Phylliida/piano/refs/README.md

# Reference repositories

Cloned here for reading, not committed. To get them back:

| folder | repository | commit read |
|---|---|---|
| `HE60` | https://github.com/peppapighs/HE60.git | `501871e` (2026-07-05) |
| `libhmk` | https://github.com/peppapighs/libhmk.git | `ad426f0` (2026-07-19) |
| `fluxpad` | https://github.com/sssata/fluxpad.git | `8b2e752` (2023-10-16) |
| `minipad-firmware` | https://github.com/minipadKB/minipad-firmware.git | `ba1b653` (2024-06-06) |
| `marbastlib` | https://github.com/ebastler/marbastlib.git | `6b0a9a7` (2026-03-22) |

The tile's sensing chain (one Hall sensor per key, an 8:1 mux per row, the
AT32F405) follows HE60, and its firmware is libhmk.
