Phylliida/piano/cad/coupon_tray.stl

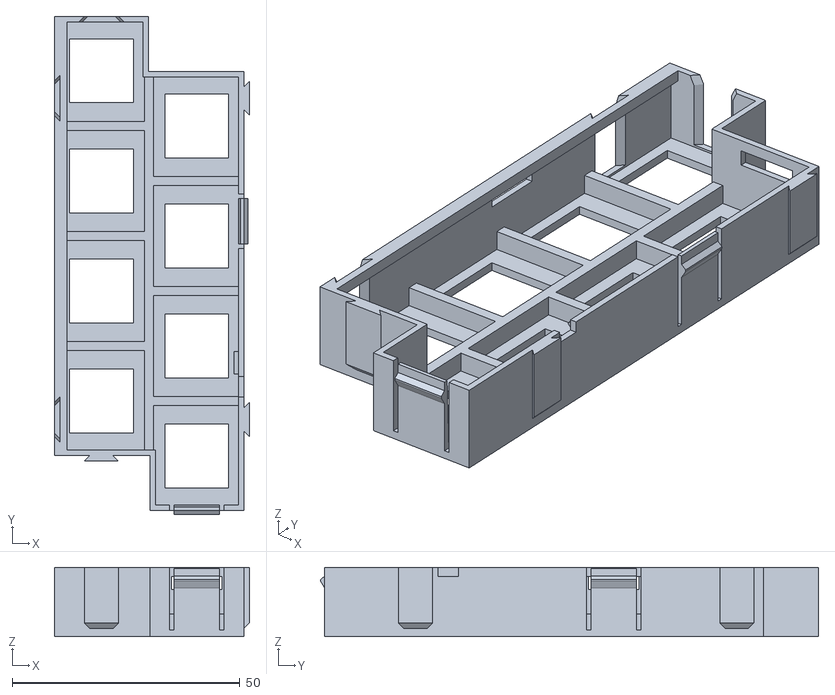
[picture p1: CAD file, 2026-11-13]
cad/coupon_tray.stl
42.8 x 109.3 x 15.2
