Phylliida/piano/cad/coupon_cover.stl

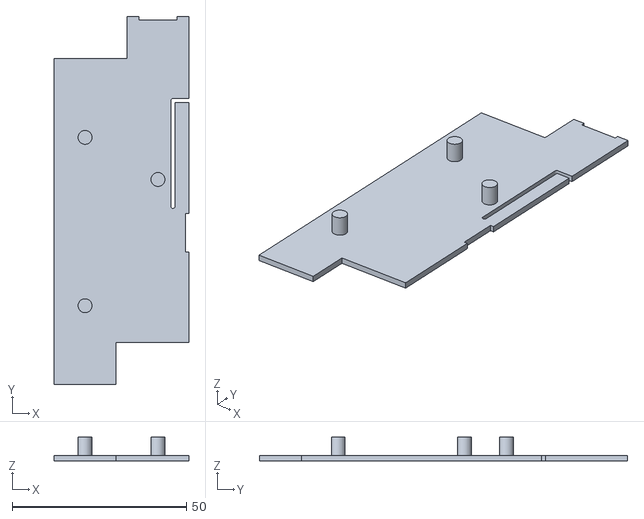
[picture p2: CAD file, 2026-11-13]
cad/coupon_cover.stl
38.7 x 105.6 x 6.80
