Phylliida/piano/cad/tray.stl

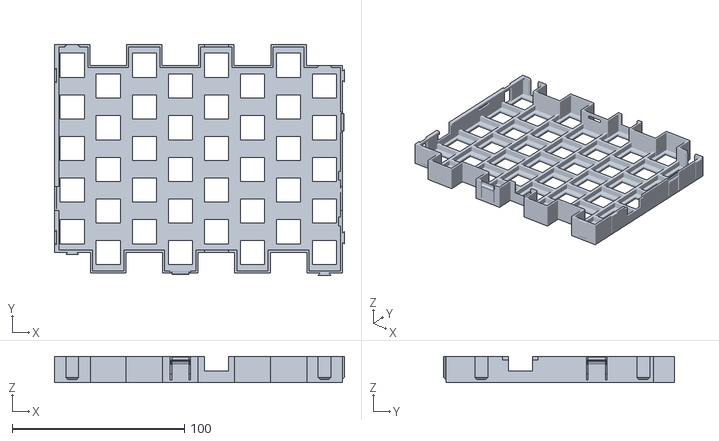
[picture p3: CAD file, 2026-11-13]
cad/tray.stl
168.3 x 133.8 x 15.2
