Phylliida/piano/cad/cover.stl

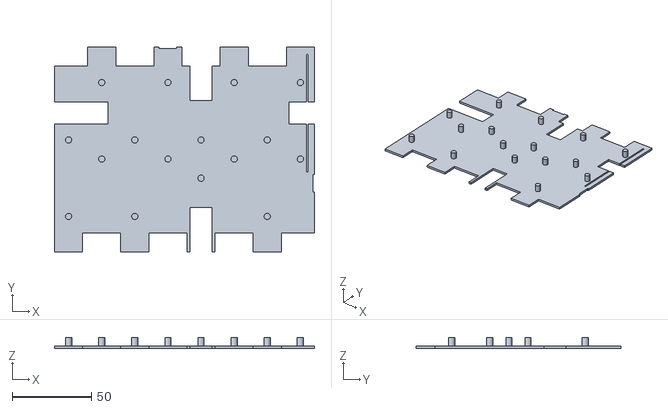
[picture p4: CAD file, 2026-11-13]
cad/cover.stl
164.2 x 129.7 x 6.80
