Phylliida/piano/cad/coupon_pcb_dummy.stl

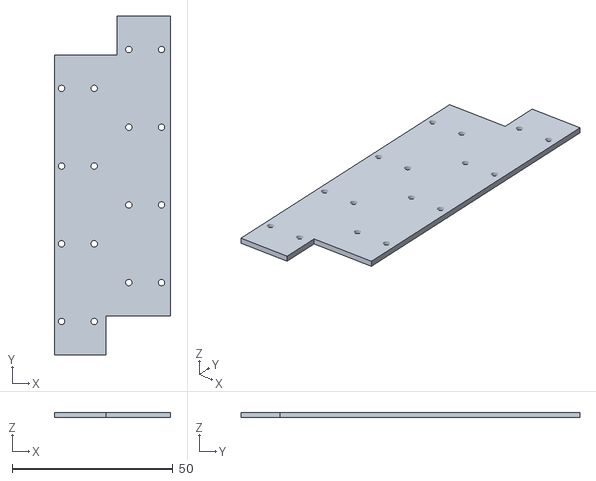
[picture p5: CAD file, 2026-11-13]
cad/coupon_pcb_dummy.stl
36.1 x 105.4 x 1.60
