Phylliida/piano/cad/plate_test.stl

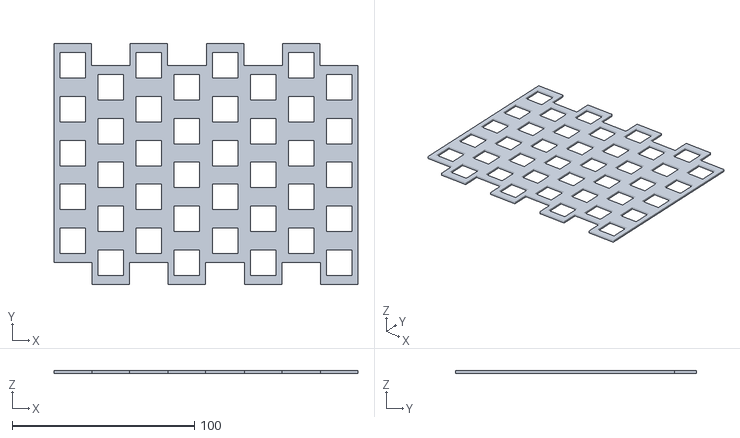
[picture p6: CAD file, 2026-11-10]
cad/plate_test.stl
167.0 x 132.5 x 1.50
