Phylliida/piano/cad/pcb_dummy.stl

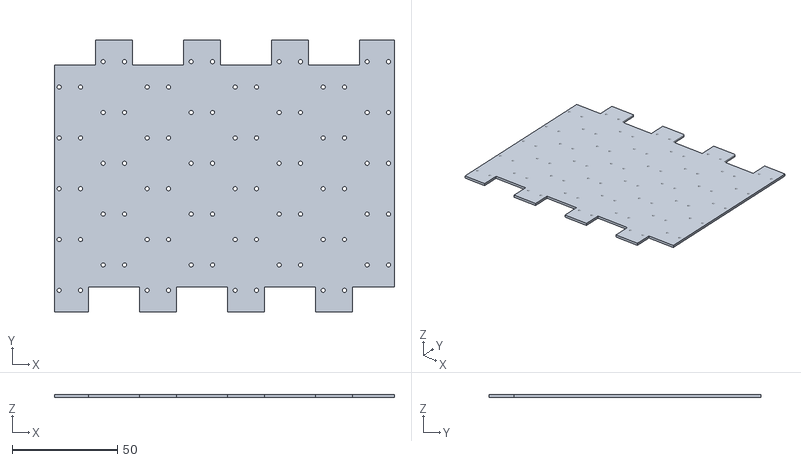
[picture p7: CAD file, 2026-11-10]
cad/pcb_dummy.stl
161.6 x 129.5 x 1.60
