Phylliida/piano/pcb/tile.kicad_pcb

## KiCad design pcb/tile.kicad_pcb (2026-11-13)

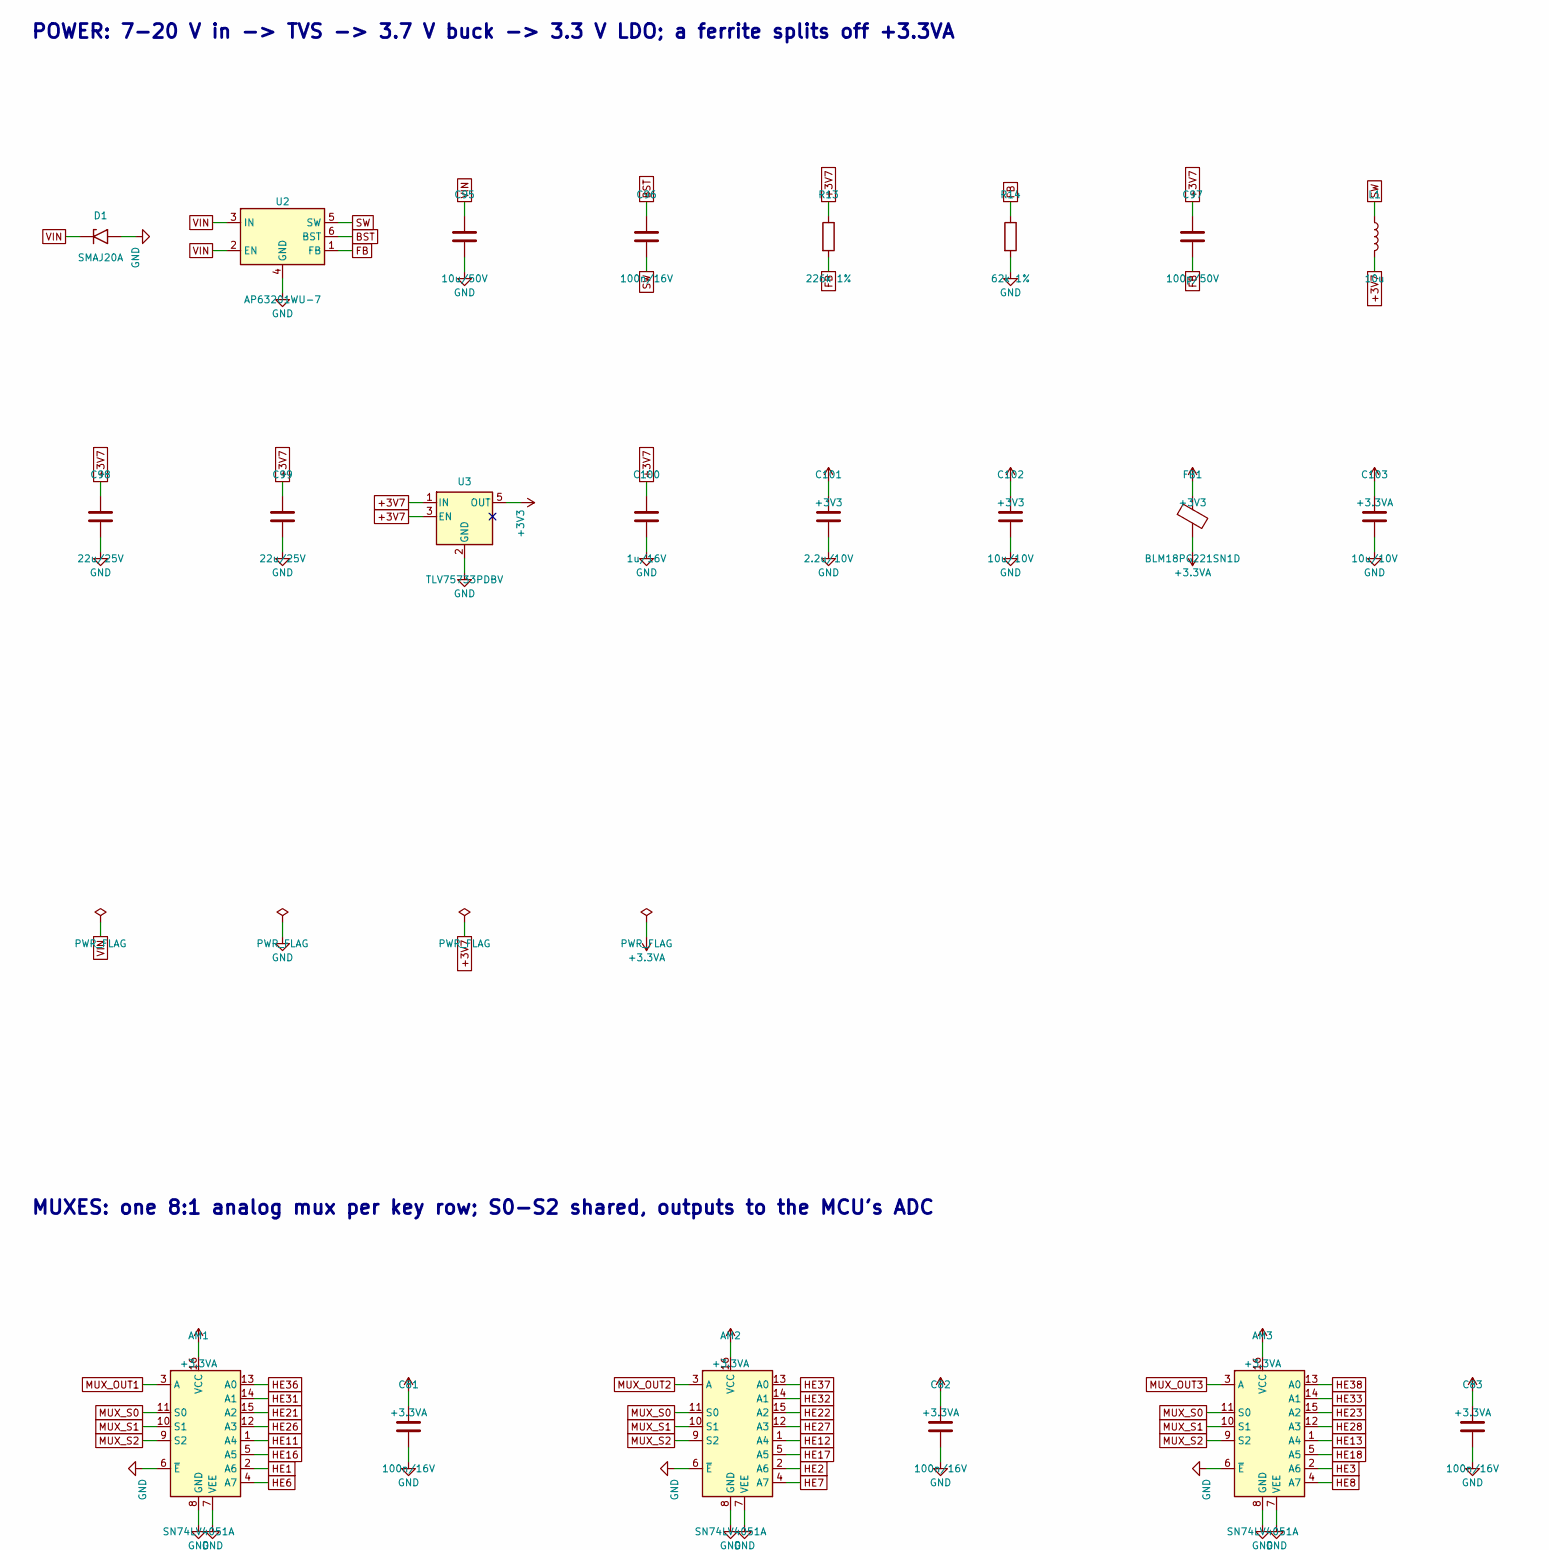
[picture p8: schematic tile.kicad_sch, Hex keyboard tile 8x5, part in row 1, column 1]

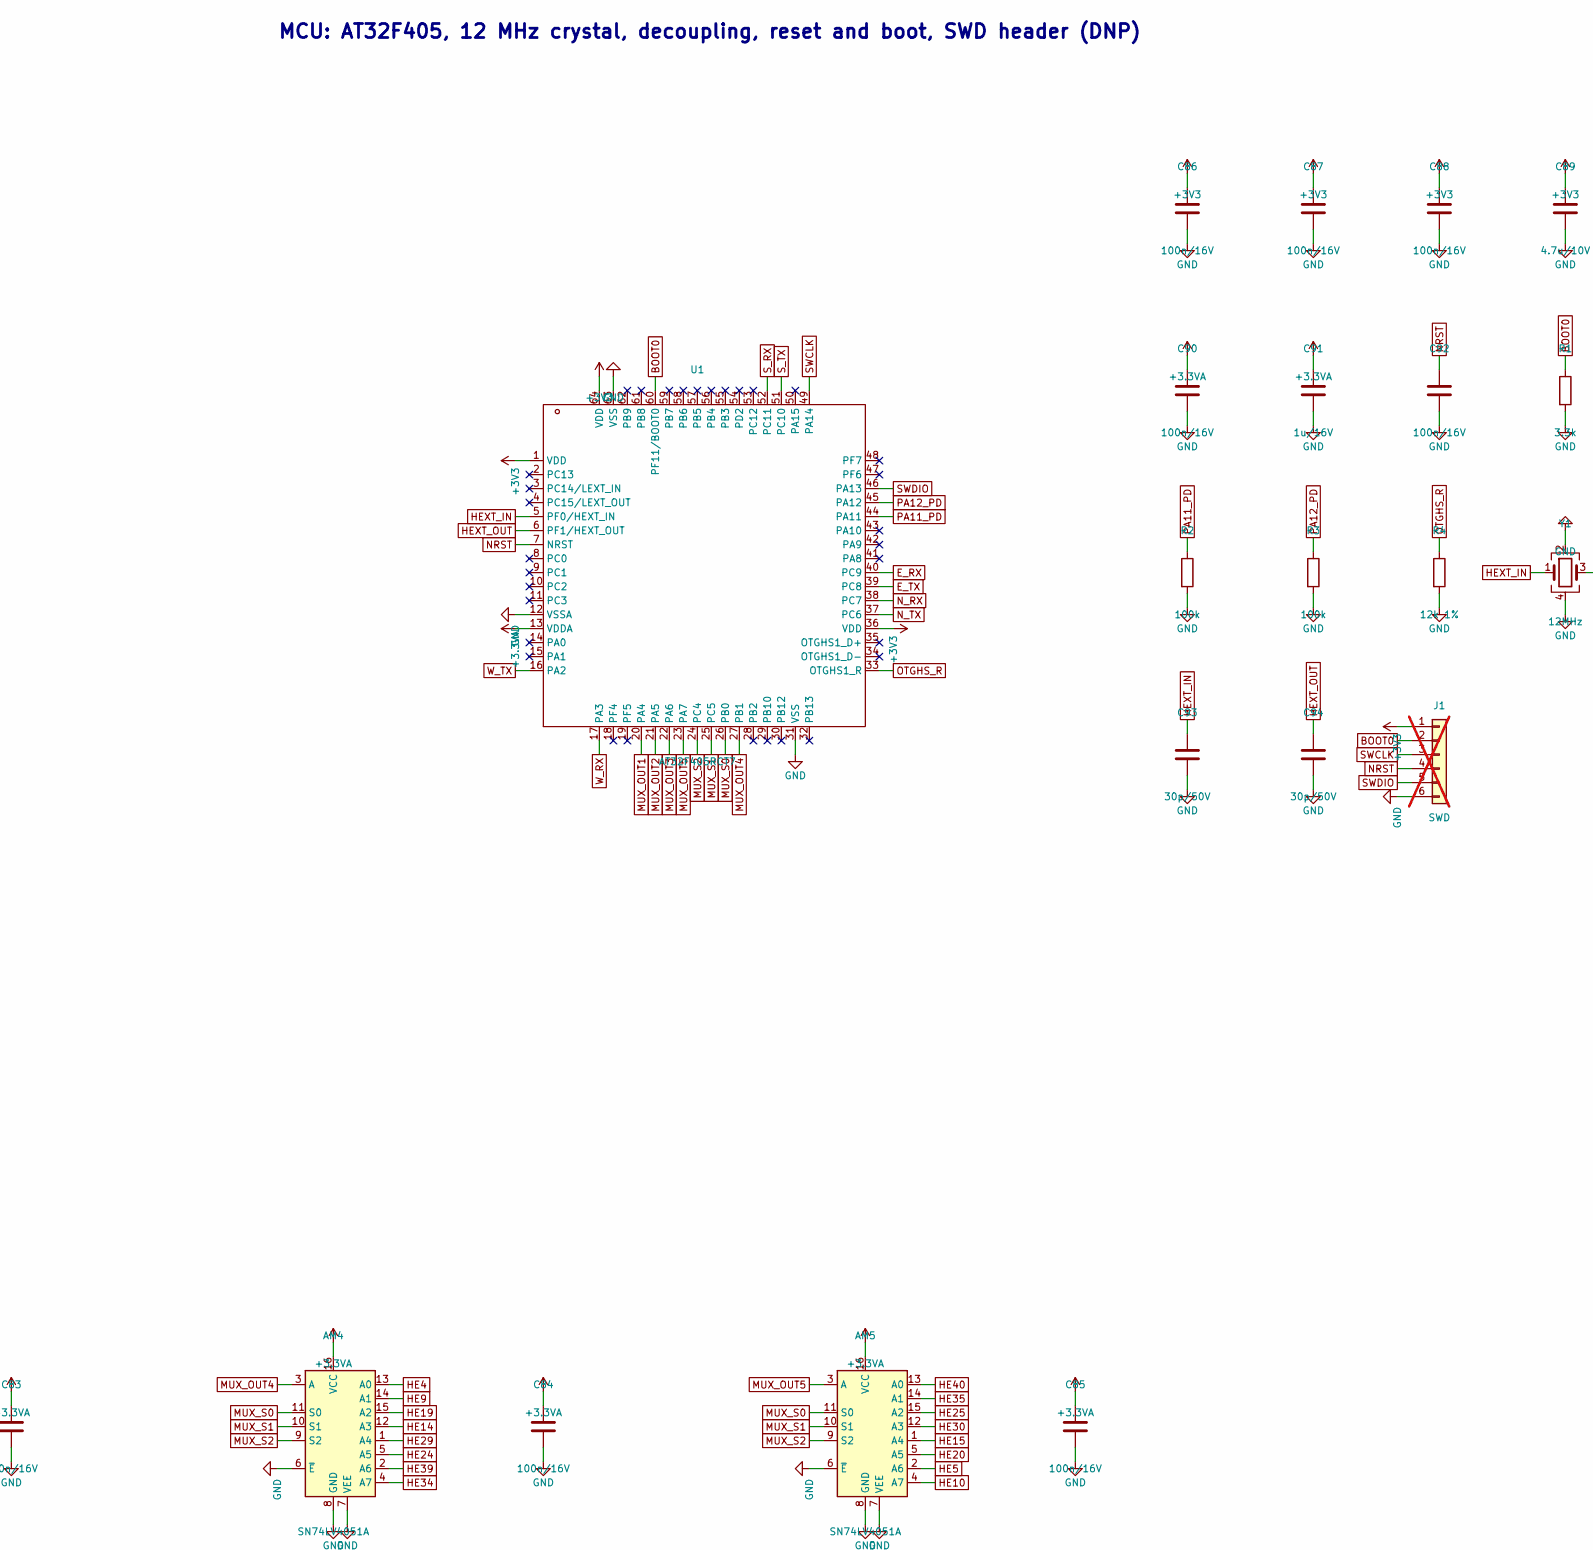
[picture p9: schematic tile.kicad_sch, Hex keyboard tile 8x5, part in row 1, column 2]

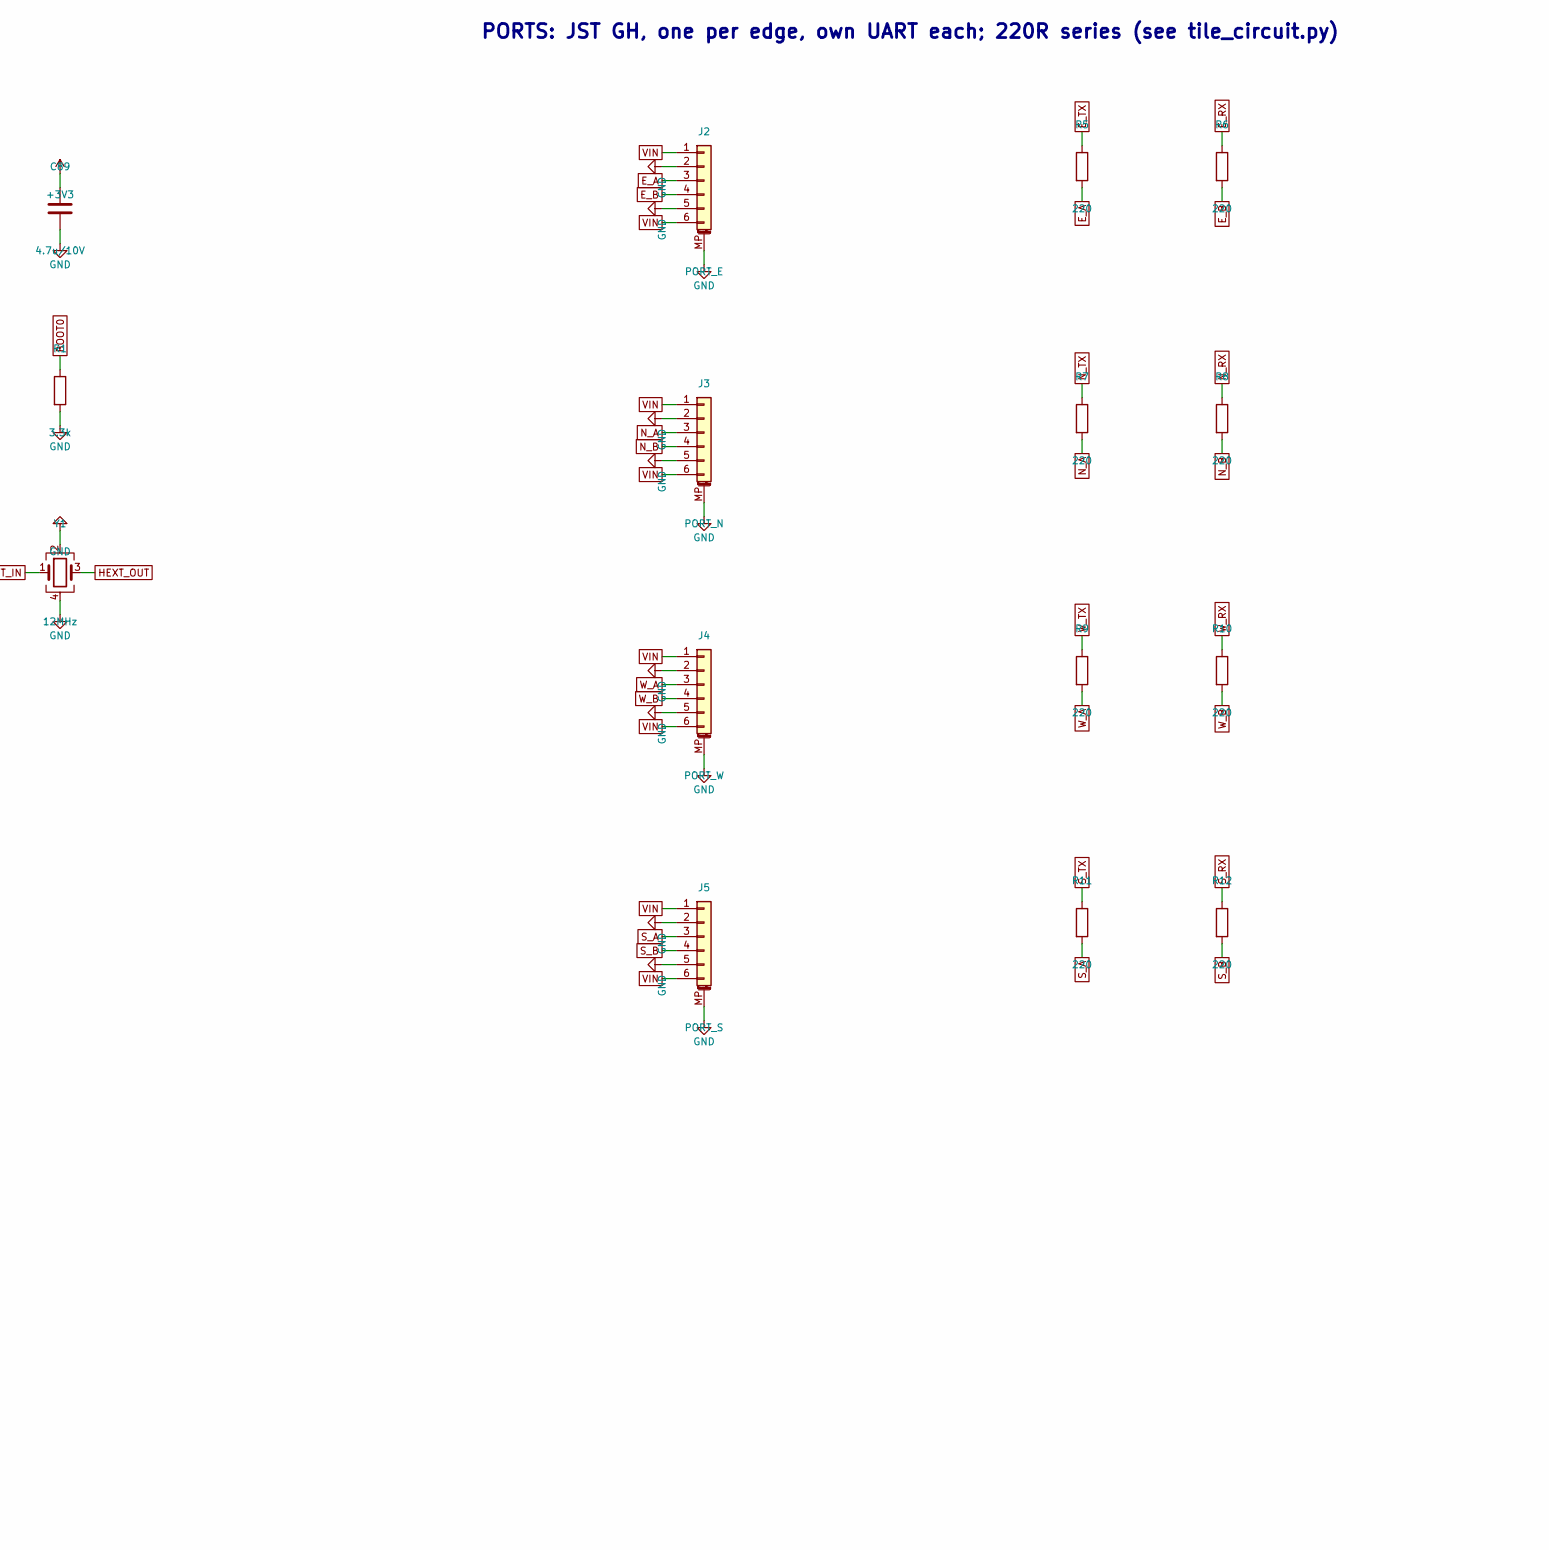
[picture p10: schematic tile.kicad_sch, Hex keyboard tile 8x5, part in row 1, column 3]

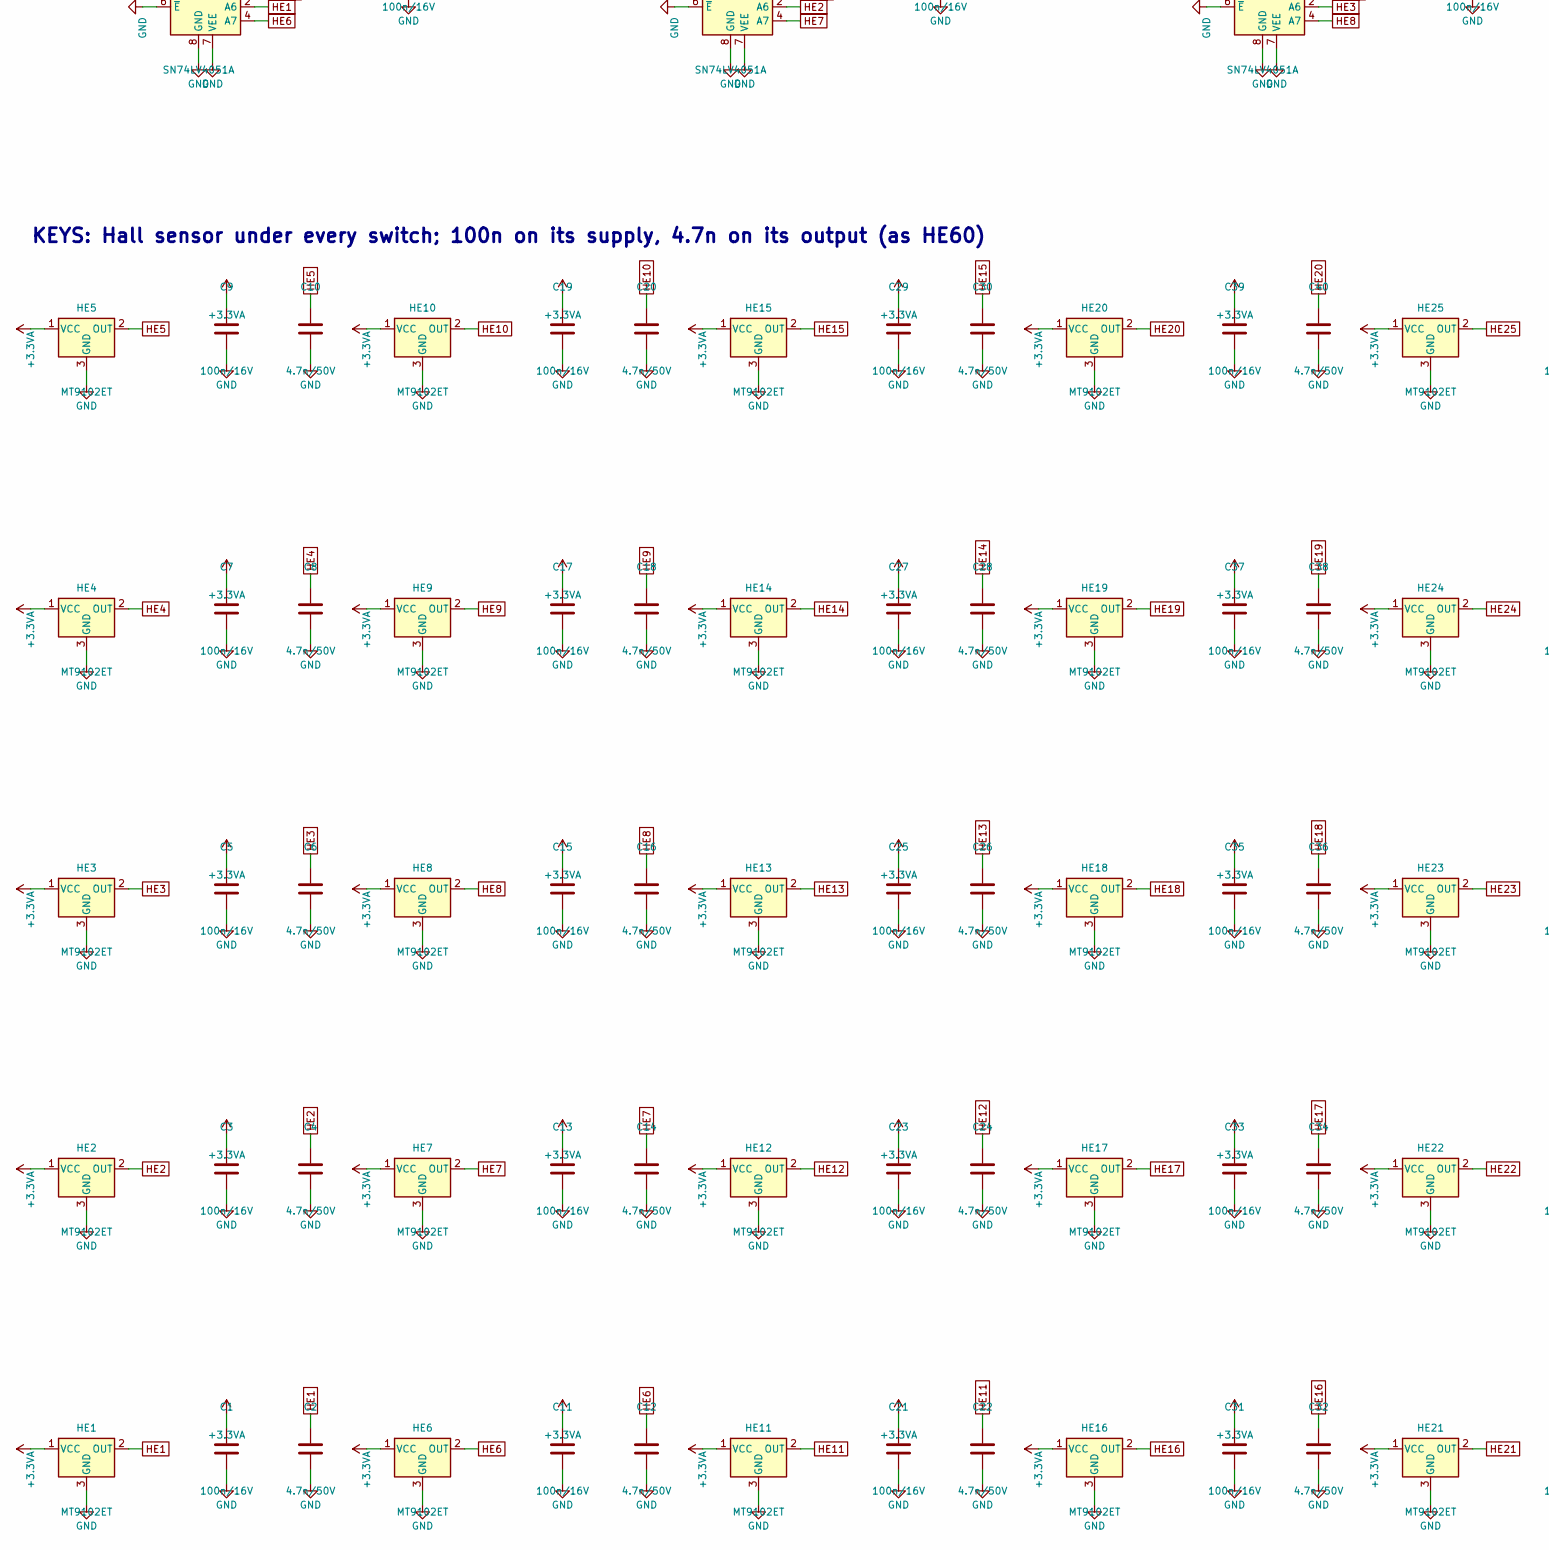
[picture p11: schematic tile.kicad_sch, Hex keyboard tile 8x5, part in row 2, column 1]

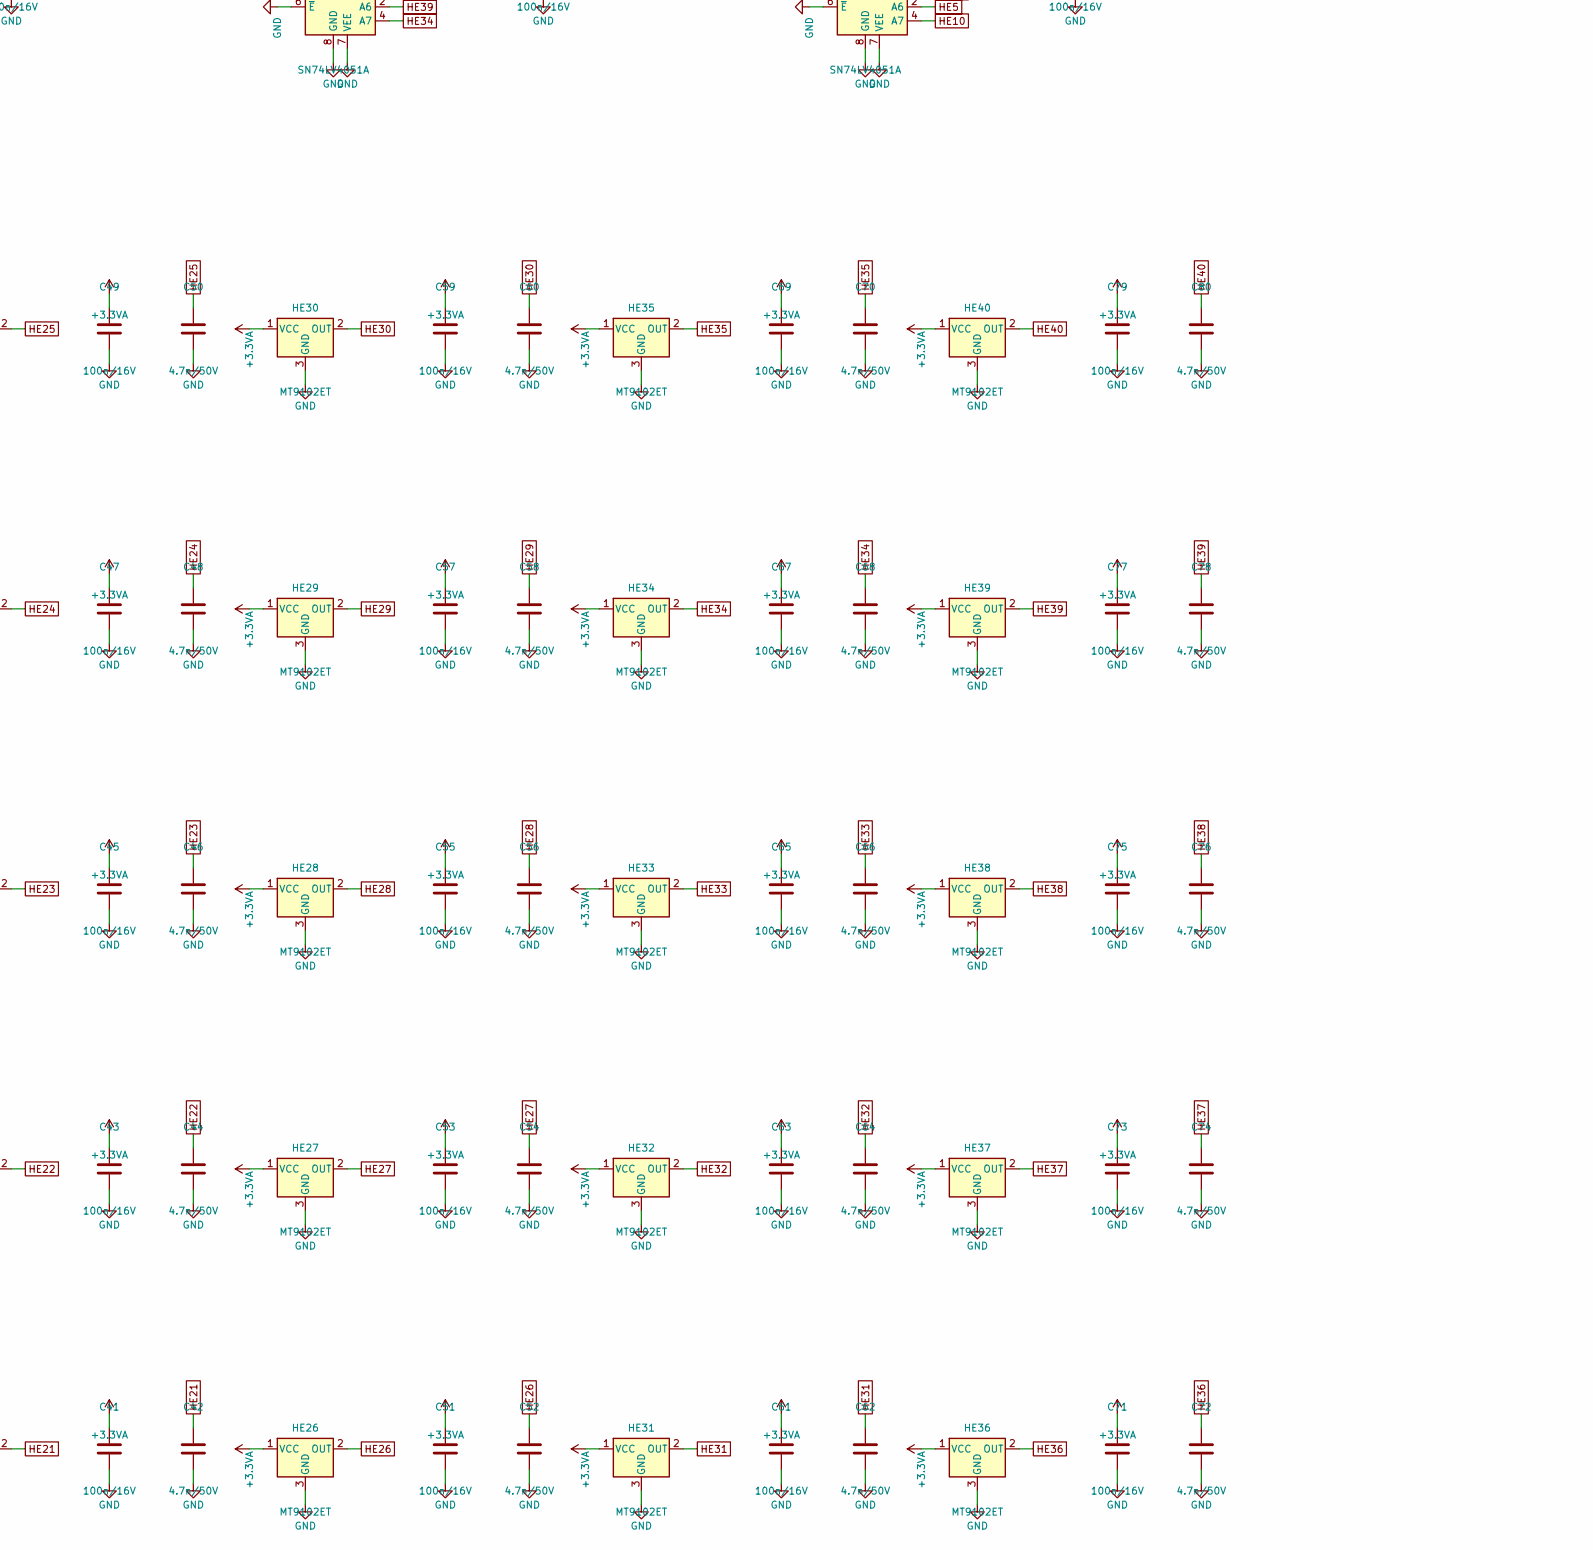
[picture p12: schematic tile.kicad_sch, Hex keyboard tile 8x5, part in row 2, column 2]

Parts:
AM1, AM2, AM3, AM4, AM5: SN74LV4051A; TSSOP-16_4.4x5mm_P0.65mm; MPN SN74LV4051APWR
C1, C3, C5, C7, C9, C11, C13, C15, C17, C19, C21, C23, C25, C27, C29, C31, C33, C35, C37, C39, C41, C43, C45, C47, C49, C51, C53, C55, C57, C59, C61, C63, C65, C67, C69, C71, C73, C75, C77, C79, C81, C82, C83, C84, C85, C86, C87, C88, C90, C92, C96: 100n/16V; C_0402_1005Metric
C2, C4, C6, C8, C10, C12, C14, C16, C18, C20, C22, C24, C26, C28, C30, C32, C34, C36, C38, C40, C42, C44, C46, C48, C50, C52, C54, C56, C58, C60, C62, C64, C66, C68, C70, C72, C74, C76, C78, C80: 4.7n/50V; C_0402_1005Metric
C89: 4.7u/10V; C_0603_1608Metric
C91, C100: 1u/16V; C_0402_1005Metric
C93, C94: 30p/50V; C_0402_1005Metric
C95: 10u/50V; C_1206_3216Metric
C97: 100p/50V; C_0402_1005Metric
C98, C99: 22u/25V; C_0805_2012Metric
C101: 2.2u/10V; C_0603_1608Metric
C102, C103: 10u/10V; C_0805_2012Metric
D1: SMAJ20A; D_SMA
FB1: BLM18PG221SN1D; L_0603_1608Metric; MPN BLM18PG221SN1D
HE1, HE2, HE3, HE4, HE5, HE6, HE7, HE8, HE9, HE10, HE11, HE12, HE13, HE14, HE15, HE16, HE17, HE18, HE19, HE20, HE21, HE22, HE23, HE24, HE25, HE26, HE27, HE28, HE29, HE30, HE31, HE32, HE33, HE34, HE35, HE36, HE37, HE38, HE39, HE40: MT9102ET; SOT-23-3
J1: SWD; PinHeader_1x06_P2.54mm_Vertical_SMD_Pin1Left; not fitted
J2: PORT_E; JST_GH_SM06B-GHS-TB_1x06-1MP_P1.25mm_Horizontal; MPN SM06B-GHS-TB
J3: PORT_N; JST_GH_SM06B-GHS-TB_1x06-1MP_P1.25mm_Horizontal; MPN SM06B-GHS-TB
J4: PORT_W; JST_GH_SM06B-GHS-TB_1x06-1MP_P1.25mm_Horizontal; MPN SM06B-GHS-TB
J5: PORT_S; JST_GH_SM06B-GHS-TB_1x06-1MP_P1.25mm_Horizontal; MPN SM06B-GHS-TB
L1: 10u; L_Changjiang_FNR4030S; MPN FNR4030S100MT
R1: 3.3k; R_0402_1005Metric
R2, R3: 100k; R_0402_1005Metric
R4: 12k 1%; R_0402_1005Metric
R5, R6, R7, R8, R9, R10, R11, R12: 220; R_0402_1005Metric
R13: 226k 1%; R_0402_1005Metric
R14: 62k 1%; R_0402_1005Metric
U1: AT32F405RCT7; LQFP-64_10x10mm_P0.5mm; MPN AT32F405RCT7
U2: AP63201WU-7; TSOT-23-6
U3: TLV75733PDBV; SOT-23-5
Y1: 12MHz; Crystal_SMD_3225-4Pin_3.2x2.5mm; MPN X322512MSB4SI

Connections:
+3.3VA: AM1.16 (VCC), AM2.16 (VCC), AM3.16 (VCC), AM4.16 (VCC), AM5.16 (VCC), C1.1, C3.1, C5.1, C7.1, C9.1, C11.1, C13.1, C15.1, C17.1, C19.1, C21.1, C23.1, C25.1, C27.1, C29.1, C31.1, C33.1, C35.1, C37.1, C39.1, C41.1, C43.1, C45.1, C47.1, C49.1, C51.1, C53.1, C55.1, C57.1, C59.1, C61.1, C63.1, C65.1, C67.1, C69.1, C71.1, C73.1, C75.1, C77.1, C79.1, C81.1, C82.1, C83.1, C84.1, C85.1, C90.1, C91.1, C103.1, FB1.2, HE1.1 (VCC), HE2.1 (VCC), HE3.1 (VCC), HE4.1 (VCC), HE5.1 (VCC), HE6.1 (VCC), HE7.1 (VCC), HE8.1 (VCC), HE9.1 (VCC), HE10.1 (VCC), HE11.1 (VCC), HE12.1 (VCC), HE13.1 (VCC), HE14.1 (VCC), HE15.1 (VCC), HE16.1 (VCC), HE17.1 (VCC), HE18.1 (VCC), HE19.1 (VCC), HE20.1 (VCC), HE21.1 (VCC), HE22.1 (VCC), HE23.1 (VCC), HE24.1 (VCC), HE25.1 (VCC), HE26.1 (VCC), HE27.1 (VCC), HE28.1 (VCC), HE29.1 (VCC), HE30.1 (VCC), HE31.1 (VCC), HE32.1 (VCC), HE33.1 (VCC), HE34.1 (VCC), HE35.1 (VCC), HE36.1 (VCC), HE37.1 (VCC), HE38.1 (VCC), HE39.1 (VCC), HE40.1 (VCC), U1.13 (VDDA)
+3V3: C86.1, C87.1, C88.1, C89.1, C101.1, C102.1, FB1.1, J1.1, U1.1 (VDD), U1.36 (VDD), U1.64 (VDD), U3.5 (OUT)
+3V7: C97.1, C98.1, C99.1, C100.1, L1.2, R13.1, U3.1 (IN), U3.3 (EN)
BOOT0: J1.2, R1.1, U1.60 (PF11/BOOT0)
BST: C96.1, U2.6 (BST)
E_A: J2.3, R5.2
E_B: J2.4, R6.2
E_RX: R6.1, U1.40 (PC9)
E_TX: R5.1, U1.39 (PC8)
FB: C97.2, R13.2, R14.1, U2.1 (FB)
GND: AM1.6 (~E), AM1.7 (VEE), AM1.8 (GND), AM2.6 (~E), AM2.7 (VEE), AM2.8 (GND), AM3.6 (~E), AM3.7 (VEE), AM3.8 (GND), AM4.6 (~E), AM4.7 (VEE), AM4.8 (GND), AM5.6 (~E), AM5.7 (VEE), AM5.8 (GND), C1.2, C2.2, C3.2, C4.2, C5.2, C6.2, C7.2, C8.2, C9.2, C10.2, C11.2, C12.2, C13.2, C14.2, C15.2, C16.2, C17.2, C18.2, C19.2, C20.2, C21.2, C22.2, C23.2, C24.2, C25.2, C26.2, C27.2, C28.2, C29.2, C30.2, C31.2, C32.2, C33.2, C34.2, C35.2, C36.2, C37.2, C38.2, C39.2, C40.2, C41.2, C42.2, C43.2, C44.2, C45.2, C46.2, C47.2, C48.2, C49.2, C50.2, C51.2, C52.2, C53.2, C54.2, C55.2, C56.2, C57.2, C58.2, C59.2, C60.2, C61.2, C62.2, C63.2, C64.2, C65.2, C66.2, C67.2, C68.2, C69.2, C70.2, C71.2, C72.2, C73.2, C74.2, C75.2, C76.2, C77.2, C78.2, C79.2, C80.2, C81.2, C82.2, C83.2, C84.2, C85.2, C86.2, C87.2, C88.2, C89.2, C90.2, C91.2, C92.2, C93.2, C94.2, C95.2, C98.2, C99.2, C100.2, C101.2, C102.2, C103.2, D1.2 (A2), HE1.3 (GND), HE2.3 (GND), HE3.3 (GND), HE4.3 (GND), HE5.3 (GND), HE6.3 (GND), HE7.3 (GND), HE8.3 (GND), HE9.3 (GND), HE10.3 (GND), HE11.3 (GND), HE12.3 (GND), HE13.3 (GND), HE14.3 (GND), HE15.3 (GND), HE16.3 (GND), HE17.3 (GND), HE18.3 (GND), HE19.3 (GND), HE20.3 (GND), HE21.3 (GND), HE22.3 (GND), HE23.3 (GND), HE24.3 (GND), HE25.3 (GND), HE26.3 (GND), HE27.3 (GND), HE28.3 (GND), HE29.3 (GND), HE30.3 (GND), HE31.3 (GND), HE32.3 (GND), HE33.3 (GND), HE34.3 (GND), HE35.3 (GND), HE36.3 (GND), HE37.3 (GND), HE38.3 (GND), HE39.3 (GND), HE40.3 (GND), J1.6, J2.2, J2.5, J2.MP (MountPin), J3.2, J3.5, J3.MP (MountPin), J4.2, J4.5, J4.MP (MountPin), J5.2, J5.5, J5.MP (MountPin), R1.2, R2.2, R3.2, R4.2, R14.2, U1.12 (VSSA), U1.31 (VSS), U1.63 (VSS), U2.4 (GND), U3.2 (GND), Y1.2, Y1.4
HE1: AM1.2 (A6), C2.1, HE1.2 (OUT)
HE2: AM2.2 (A6), C4.1, HE2.2 (OUT)
HE3: AM3.2 (A6), C6.1, HE3.2 (OUT)
HE4: AM4.13 (A0), C8.1, HE4.2 (OUT)
HE5: AM5.2 (A6), C10.1, HE5.2 (OUT)
HE6: AM1.4 (A7), C12.1, HE6.2 (OUT)
HE7: AM2.4 (A7), C14.1, HE7.2 (OUT)
HE8: AM3.4 (A7), C16.1, HE8.2 (OUT)
HE9: AM4.14 (A1), C18.1, HE9.2 (OUT)
HE10: AM5.4 (A7), C20.1, HE10.2 (OUT)
HE11: AM1.1 (A4), C22.1, HE11.2 (OUT)
HE12: AM2.1 (A4), C24.1, HE12.2 (OUT)
HE13: AM3.1 (A4), C26.1, HE13.2 (OUT)
HE14: AM4.12 (A3), C28.1, HE14.2 (OUT)
HE15: AM5.1 (A4), C30.1, HE15.2 (OUT)
HE16: AM1.5 (A5), C32.1, HE16.2 (OUT)
HE17: AM2.5 (A5), C34.1, HE17.2 (OUT)
HE18: AM3.5 (A5), C36.1, HE18.2 (OUT)
HE19: AM4.15 (A2), C38.1, HE19.2 (OUT)
HE20: AM5.5 (A5), C40.1, HE20.2 (OUT)
HE21: AM1.15 (A2), C42.1, HE21.2 (OUT)
HE22: AM2.15 (A2), C44.1, HE22.2 (OUT)
HE23: AM3.15 (A2), C46.1, HE23.2 (OUT)
HE24: AM4.5 (A5), C48.1, HE24.2 (OUT)
HE25: AM5.15 (A2), C50.1, HE25.2 (OUT)
HE26: AM1.12 (A3), C52.1, HE26.2 (OUT)
HE27: AM2.12 (A3), C54.1, HE27.2 (OUT)
HE28: AM3.12 (A3), C56.1, HE28.2 (OUT)
HE29: AM4.1 (A4), C58.1, HE29.2 (OUT)
HE30: AM5.12 (A3), C60.1, HE30.2 (OUT)
HE31: AM1.14 (A1), C62.1, HE31.2 (OUT)
HE32: AM2.14 (A1), C64.1, HE32.2 (OUT)
HE33: AM3.14 (A1), C66.1, HE33.2 (OUT)
HE34: AM4.4 (A7), C68.1, HE34.2 (OUT)
HE35: AM5.14 (A1), C70.1, HE35.2 (OUT)
HE36: AM1.13 (A0), C72.1, HE36.2 (OUT)
HE37: AM2.13 (A0), C74.1, HE37.2 (OUT)
HE38: AM3.13 (A0), C76.1, HE38.2 (OUT)
HE39: AM4.2 (A6), C78.1, HE39.2 (OUT)
HE40: AM5.13 (A0), C80.1, HE40.2 (OUT)
HEXT_IN: C93.1, U1.5 (PF0/HEXT_IN), Y1.1
HEXT_OUT: C94.1, U1.6 (PF1/HEXT_OUT), Y1.3
MUX_OUT1: AM1.3 (A), U1.20 (PA4)
MUX_OUT2: AM2.3 (A), U1.21 (PA5)
MUX_OUT3: AM3.3 (A), U1.22 (PA6)
MUX_OUT4: AM4.3 (A), U1.27 (PB1)
MUX_OUT5: AM5.3 (A), U1.23 (PA7)
MUX_S0: AM1.11 (S0), AM2.11 (S0), AM3.11 (S0), AM4.11 (S0), AM5.11 (S0), U1.26 (PB0)
MUX_S1: AM1.10 (S1), AM2.10 (S1), AM3.10 (S1), AM4.10 (S1), AM5.10 (S1), U1.25 (PC5)
MUX_S2: AM1.9 (S2), AM2.9 (S2), AM3.9 (S2), AM4.9 (S2), AM5.9 (S2), U1.24 (PC4)
NRST: C92.1, J1.4, U1.7 (NRST)
N_A: J3.3, R7.2
N_B: J3.4, R8.2
N_RX: R8.1, U1.38 (PC7)
N_TX: R7.1, U1.37 (PC6)
OTGHS_R: R4.1, U1.33 (OTGHS1_R)
PA11_PD: R2.1, U1.44 (PA11)
PA12_PD: R3.1, U1.45 (PA12)
SW: C96.2, L1.1, U2.5 (SW)
SWCLK: J1.3, U1.49 (PA14)
SWDIO: J1.5, U1.46 (PA13)
S_A: J5.3, R11.2
S_B: J5.4, R12.2
S_RX: R12.1, U1.52 (PC11)
S_TX: R11.1, U1.51 (PC10)
VIN: C95.1, D1.1 (A1), J2.1, J2.6, J3.1, J3.6, J4.1, J4.6, J5.1, J5.6, U2.2 (EN), U2.3 (IN)
W_A: J4.3, R9.2
W_B: J4.4, R10.2
W_RX: R10.1, U1.17 (PA3)
W_TX: R9.1, U1.16 (PA2)

Notes on the sheet:
KEYS: Hall sensor under every switch; 100n on its supply, 4.7n on its output (as HE60)
MUXES: one 8:1 analog mux per key row; S0-S2 shared, outputs to the MCU's ADC
MCU: AT32F405, 12 MHz crystal, decoupling, reset and boot, SWD header (DNP)
PORTS: JST GH, one per edge, own UART each; 220R series (see tile_circuit.py)
POWER: 7-20 V in -> TVS -> 3.7 V buck -> 3.3 V LDO; a ferrite splits off +3.3VA

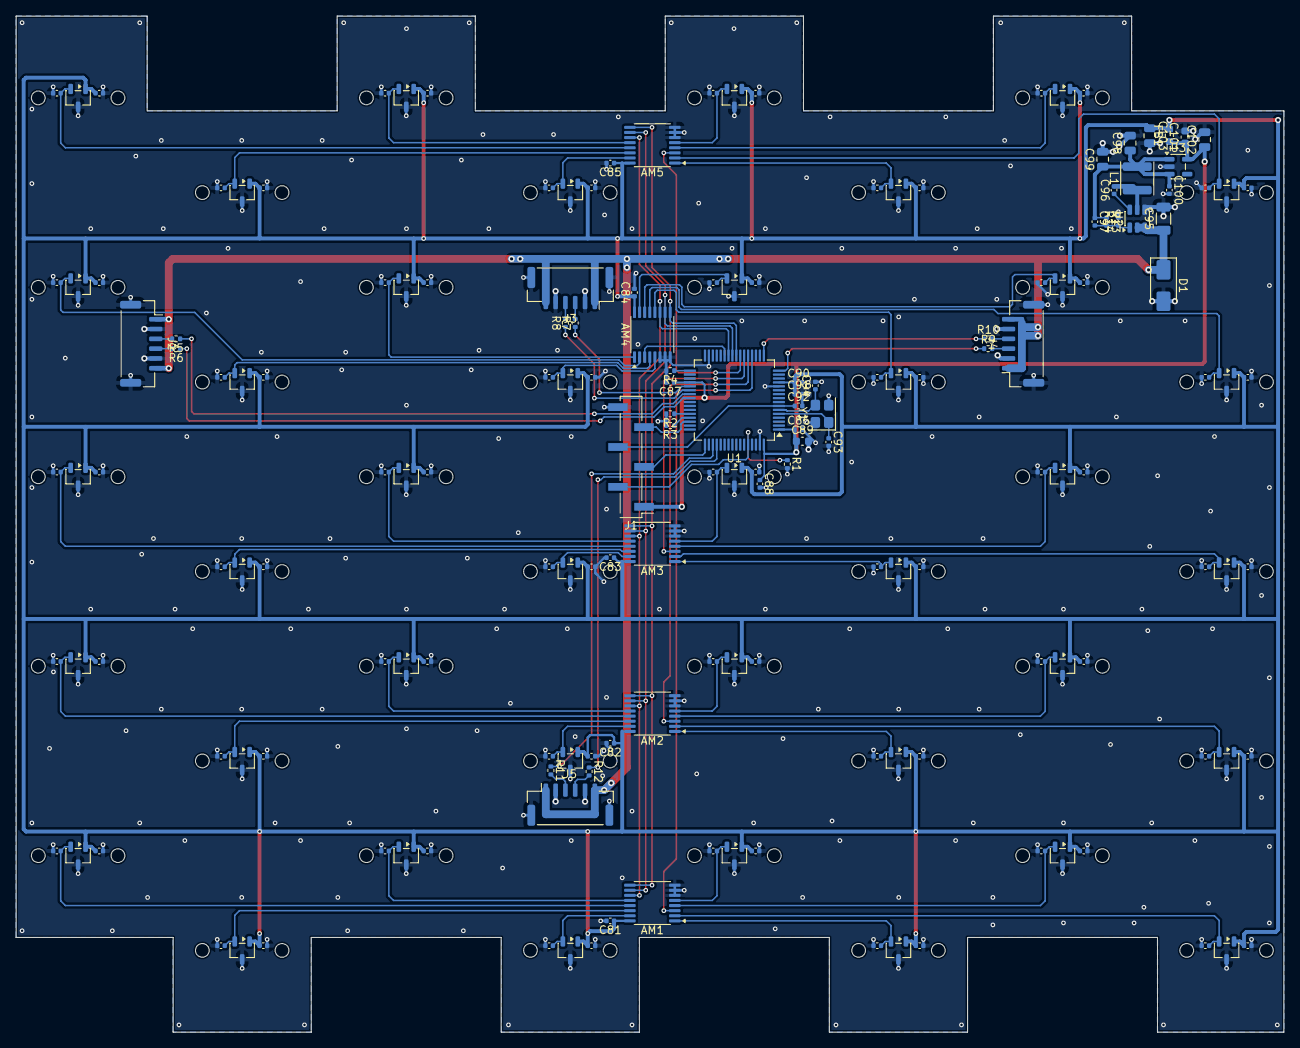
[picture p13: board tile.kicad_pcb from below]

Board: 2 copper layers, 161.6 x 129.5 mm, 214 parts (174 on the bottom side), 81 nets.

Other parts of the board:
SW1, SW2, SW3, SW4, SW5, SW6, SW7, SW8, SW9, SW10, SW11, SW12, SW13, SW14, SW15, SW16, SW17, SW18, SW19, SW20, SW21, SW22, SW23, SW24, SW25, SW26, SW27, SW28, SW29, SW30, SW31, SW32, SW33, SW34, SW35, SW36, SW37, SW38, SW39, SW40: MX_HE; MX-1U
