Phylliida/piano/kicad/tile95.kicad_pcb

## KiCad design kicad/tile95.kicad_pcb (2026-11-10)

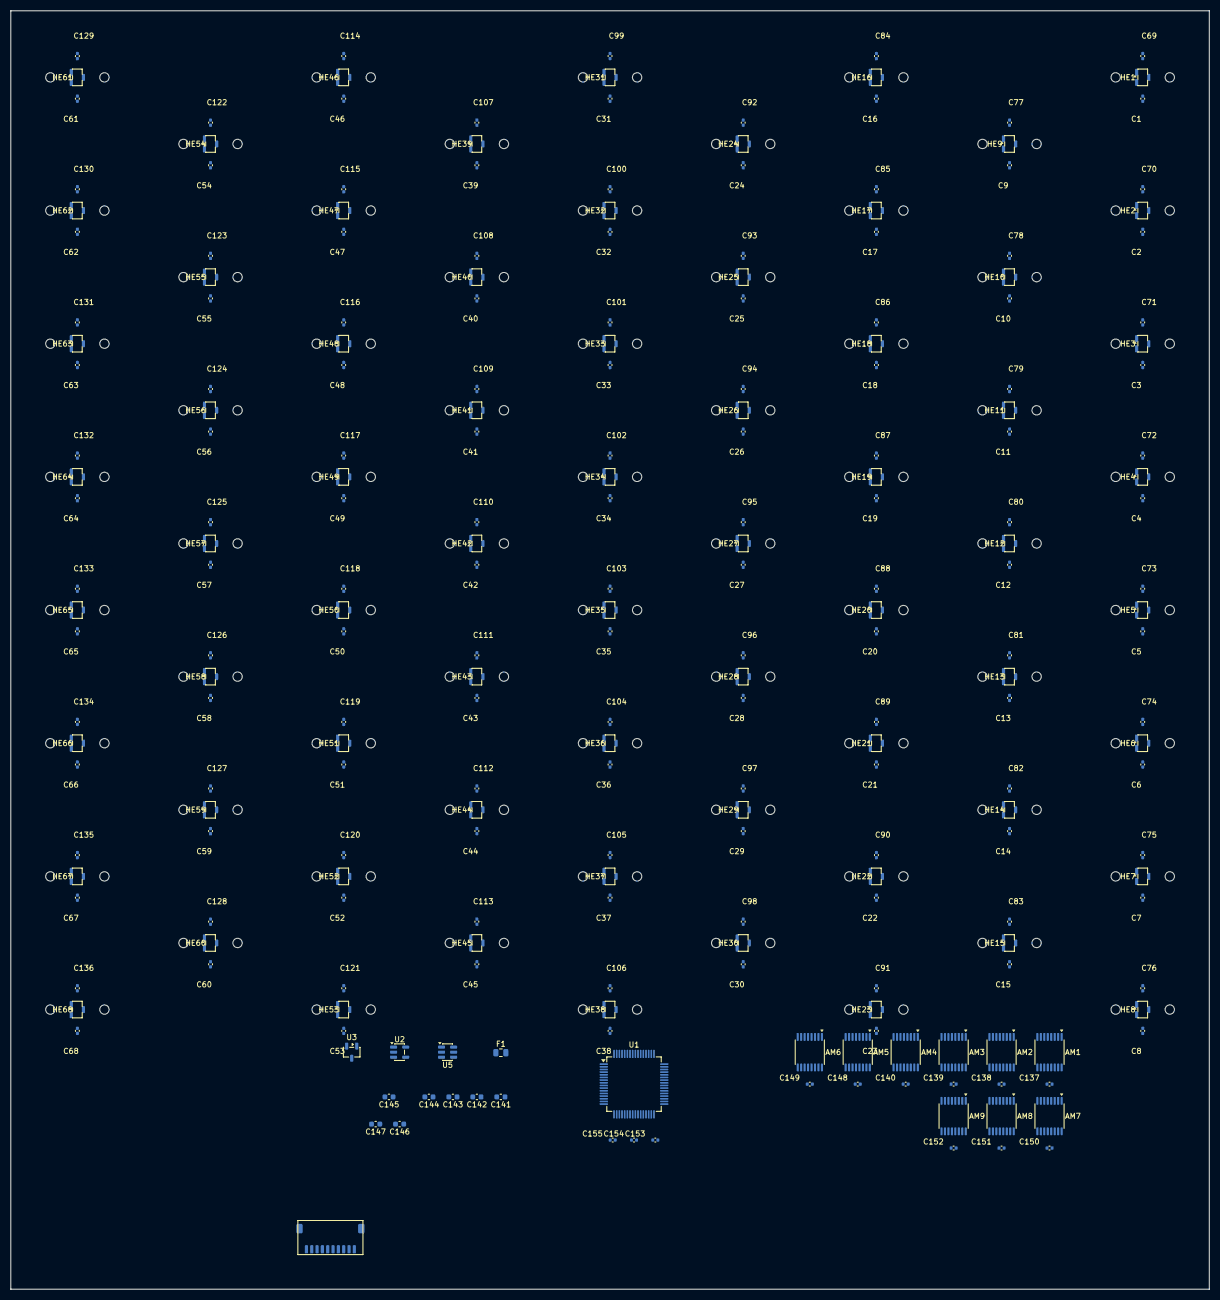
[picture p14: board tile95.kicad_pcb from below]

Board: 2 copper layers, 225.0 x 240.0 mm, 306 parts (238 on the bottom side), 89 nets, no tracks yet.

Parts:
AM1, AM2, AM3, AM4, AM5, AM6, AM7, AM8, AM9: SN74LV4051A; TSSOP-16_4.4x5mm_P0.65mm
C1, C2, C3, C4, C5, C6, C7, C8, C9, C10, C11, C12, C13, C14, C15, C16, C17, C18, C19, C20, C21, C22, C23, C24, C25, C26, C27, C28, C29, C30, C31, C32, C33, C34, C35, C36, C37, C38, C39, C40, C41, C42, C43, C44, C45, C46, C47, C48, C49, C50, C51, C52, C53, C54, C55, C56, C57, C58, C59, C60, C61, C62, C63, C64, C65, C66, C67, C68: 4.7n; C_0402_1005Metric
C69, C70, C71, C72, C73, C74, C75, C76, C77, C78, C79, C80, C81, C82, C83, C84, C85, C86, C87, C88, C89, C90, C91, C92, C93, C94, C95, C96, C97, C98, C99, C100, C101, C102, C103, C104, C105, C106, C107, C108, C109, C110, C111, C112, C113, C114, C115, C116, C117, C118, C119, C120, C121, C122, C123, C124, C125, C126, C127, C128, C129, C130, C131, C132, C133, C134, C135, C136, C137, C138, C139, C140, C148, C149, C150, C151, C152, C153, C154, C155: 100n; C_0402_1005Metric
C141, C142, C143, C144, C146: 2.2u; C_0603_1608Metric
C145: 10u; C_0603_1608Metric
C147: 1u; C_0603_1608Metric
F1: BSMD0805-050-24V; Fuse_0805_2012Metric
HE1, HE2, HE3, HE4, HE5, HE6, HE7, HE8, HE9, HE10, HE11, HE12, HE13, HE14, HE15, HE16, HE17, HE18, HE19, HE20, HE21, HE22, HE23, HE24, HE25, HE26, HE27, HE28, HE29, HE30, HE31, HE32, HE33, HE34, HE35, HE36, HE37, HE38, HE39, HE40, HE41, HE42, HE43, HE44, HE45, HE46, HE47, HE48, HE49, HE50, HE51, HE52, HE53, HE54, HE55, HE56, HE57, HE58, HE59, HE60, HE61, HE62, HE63, HE64, HE65, HE66, HE67, HE68: GH39FKSW; SOT-23-3
J1: SM10B-SRSS-TB; JST_SH_SM10B-SRSS-TB_1x10-1MP_P1.00mm_Horizontal
SW1, SW2, SW3, SW4, SW5, SW6, SW7, SW8, SW9, SW10, SW11, SW12, SW13, SW14, SW15, SW16, SW17, SW18, SW19, SW20, SW21, SW22, SW23, SW24, SW25, SW26, SW27, SW28, SW29, SW30, SW31, SW32, SW33, SW34, SW35, SW36, SW37, SW38, SW39, SW40, SW41, SW42, SW43, SW44, SW45, SW46, SW47, SW48, SW49, SW50, SW51, SW52, SW53, SW54, SW55, SW56, SW57, SW58, SW59, SW60, SW61, SW62, SW63, SW64, SW65, SW66, SW67, SW68: MX-1U
U1: AT32F405RCT7; LQFP-64_10x10mm_P0.5mm
U2: TLV75733PDBV; SOT-23-5
U3: XC6206P332MR-G; SOT-23-3
U5: USBLC6-2SC6; SOT-23-6

Connections:
5V: C141.1, C142.1, C143.1, C144.1, F1.2, U2.1 (IN), U2.3 (EN), U3.3 (GND), U5.5 (VBUS)
+3V3: C145.1, C153.1, C154.1, C155.1, U1.1 (VDD), U1.36 (VDD), U1.64 (VDD), U3.2 (OUT)
+3V3A: AM1.16 (VDD), AM2.16 (VDD), AM3.16 (VDD), AM4.16 (VDD), AM5.16 (VDD), AM6.16 (VDD), AM7.16 (VDD), AM8.16 (VDD), AM9.16 (VDD), C69.1, C70.1, C71.1, C72.1, C73.1, C74.1, C75.1, C76.1, C77.1, C78.1, C79.1, C80.1, C81.1, C82.1, C83.1, C84.1, C85.1, C86.1, C87.1, C88.1, C89.1, C90.1, C91.1, C92.1, C93.1, C94.1, C95.1, C96.1, C97.1, C98.1, C99.1, C100.1, C101.1, C102.1, C103.1, C104.1, C105.1, C106.1, C107.1, C108.1, C109.1, C110.1, C111.1, C112.1, C113.1, C114.1, C115.1, C116.1, C117.1, C118.1, C119.1, C120.1, C121.1, C122.1, C123.1, C124.1, C125.1, C126.1, C127.1, C128.1, C129.1, C130.1, C131.1, C132.1, C133.1, C134.1, C135.1, C136.1, C137.1, C138.1, C139.1, C140.1, C146.1, C147.1, C148.1, C149.1, C150.1, C151.1, C152.1, HE1.1 (VCC), HE2.1 (VCC), HE3.1 (VCC), HE4.1 (VCC), HE5.1 (VCC), HE6.1 (VCC), HE7.1 (VCC), HE8.1 (VCC), HE9.1 (VCC), HE10.1 (VCC), HE11.1 (VCC), HE12.1 (VCC), HE13.1 (VCC), HE14.1 (VCC), HE15.1 (VCC), HE16.1 (VCC), HE17.1 (VCC), HE18.1 (VCC), HE19.1 (VCC), HE20.1 (VCC), HE21.1 (VCC), HE22.1 (VCC), HE23.1 (VCC), HE24.1 (VCC), HE25.1 (VCC), HE26.1 (VCC), HE27.1 (VCC), HE28.1 (VCC), HE29.1 (VCC), HE30.1 (VCC), HE31.1 (VCC), HE32.1 (VCC), HE33.1 (VCC), HE34.1 (VCC), HE35.1 (VCC), HE36.1 (VCC), HE37.1 (VCC), HE38.1 (VCC), HE39.1 (VCC), HE40.1 (VCC), HE41.1 (VCC), HE42.1 (VCC), HE43.1 (VCC), HE44.1 (VCC), HE45.1 (VCC), HE46.1 (VCC), HE47.1 (VCC), HE48.1 (VCC), HE49.1 (VCC), HE50.1 (VCC), HE51.1 (VCC), HE52.1 (VCC), HE53.1 (VCC), HE54.1 (VCC), HE55.1 (VCC), HE56.1 (VCC), HE57.1 (VCC), HE58.1 (VCC), HE59.1 (VCC), HE60.1 (VCC), HE61.1 (VCC), HE62.1 (VCC), HE63.1 (VCC), HE64.1 (VCC), HE65.1 (VCC), HE66.1 (VCC), HE67.1 (VCC), HE68.1 (VCC), U1.13 (VDDA), U2.5 (OUT)
GND: AM1.6 (Inh), AM1.7 (VEE), AM1.8 (VSS), AM2.6 (Inh), AM2.7 (VEE), AM2.8 (VSS), AM3.6 (Inh), AM3.7 (VEE), AM3.8 (VSS), AM4.6 (Inh), AM4.7 (VEE), AM4.8 (VSS), AM5.6 (Inh), AM5.7 (VEE), AM5.8 (VSS), AM6.6 (Inh), AM6.7 (VEE), AM6.8 (VSS), AM7.6 (Inh), AM7.7 (VEE), AM7.8 (VSS), AM8.6 (Inh), AM8.7 (VEE), AM8.8 (VSS), AM9.6 (Inh), AM9.7 (VEE), AM9.8 (VSS), AM9.12 (X3), AM9.13 (X0), AM9.14 (X1), AM9.15 (X2), C1.2, C2.2, C3.2, C4.2, C5.2, C6.2, C7.2, C8.2, C9.2, C10.2, C11.2, C12.2, C13.2, C14.2, C15.2, C16.2, C17.2, C18.2, C19.2, C20.2, C21.2, C22.2, C23.2, C24.2, C25.2, C26.2, C27.2, C28.2, C29.2, C30.2, C31.2, C32.2, C33.2, C34.2, C35.2, C36.2, C37.2, C38.2, C39.2, C40.2, C41.2, C42.2, C43.2, C44.2, C45.2, C46.2, C47.2, C48.2, C49.2, C50.2, C51.2, C52.2, C53.2, C54.2, C55.2, C56.2, C57.2, C58.2, C59.2, C60.2, C61.2, C62.2, C63.2, C64.2, C65.2, C66.2, C67.2, C68.2, C69.2, C70.2, C71.2, C72.2, C73.2, C74.2, C75.2, C76.2, C77.2, C78.2, C79.2, C80.2, C81.2, C82.2, C83.2, C84.2, C85.2, C86.2, C87.2, C88.2, C89.2, C90.2, C91.2, C92.2, C93.2, C94.2, C95.2, C96.2, C97.2, C98.2, C99.2, C100.2, C101.2, C102.2, C103.2, C104.2, C105.2, C106.2, C107.2, C108.2, C109.2, C110.2, C111.2, C112.2, C113.2, C114.2, C115.2, C116.2, C117.2, C118.2, C119.2, C120.2, C121.2, C122.2, C123.2, C124.2, C125.2, C126.2, C127.2, C128.2, C129.2, C130.2, C131.2, C132.2, C133.2, C134.2, C135.2, C136.2, C137.2, C138.2, C139.2, C140.2, C141.2, C142.2, C143.2, C144.2, C145.2, C146.2, C147.2, C148.2, C149.2, C150.2, C151.2, C152.2, C153.2, C154.2, C155.2, HE1.3 (GND), HE2.3 (GND), HE3.3 (GND), HE4.3 (GND), HE5.3 (GND), HE6.3 (GND), HE7.3 (GND), HE8.3 (GND), HE9.3 (GND), HE10.3 (GND), HE11.3 (GND), HE12.3 (GND), HE13.3 (GND), HE14.3 (GND), HE15.3 (GND), HE16.3 (GND), HE17.3 (GND), HE18.3 (GND), HE19.3 (GND), HE20.3 (GND), HE21.3 (GND), HE22.3 (GND), HE23.3 (GND), HE24.3 (GND), HE25.3 (GND), HE26.3 (GND), HE27.3 (GND), HE28.3 (GND), HE29.3 (GND), HE30.3 (GND), HE31.3 (GND), HE32.3 (GND), HE33.3 (GND), HE34.3 (GND), HE35.3 (GND), HE36.3 (GND), HE37.3 (GND), HE38.3 (GND), HE39.3 (GND), HE40.3 (GND), HE41.3 (GND), HE42.3 (GND), HE43.3 (GND), HE44.3 (GND), HE45.3 (GND), HE46.3 (GND), HE47.3 (GND), HE48.3 (GND), HE49.3 (GND), HE50.3 (GND), HE51.3 (GND), HE52.3 (GND), HE53.3 (GND), HE54.3 (GND), HE55.3 (GND), HE56.3 (GND), HE57.3 (GND), HE58.3 (GND), HE59.3 (GND), HE60.3 (GND), HE61.3 (GND), HE62.3 (GND), HE63.3 (GND), HE64.3 (GND), HE65.3 (GND), HE66.3 (GND), HE67.3 (GND), HE68.3 (GND), J1.3, J1.4, J1.7, J1.8, U1.12 (VSSA), U1.31 (VSS), U1.63 (VSS), U2.2 (GND), U3.1 (VCC), U5.2 (GND)
HE1: AM1.1 (X4), C1.1, HE1.2 (OUT)
HE2: AM1.2 (X6), C2.1, HE2.2 (OUT)
HE3: AM1.4 (X7), C3.1, HE3.2 (OUT)
HE4: AM1.5 (X5), C4.1, HE4.2 (OUT)
HE5: AM1.15 (X2), C5.1, HE5.2 (OUT)
HE6: AM1.14 (X1), C6.1, HE6.2 (OUT)
HE7: AM1.13 (X0), C7.1, HE7.2 (OUT)
HE8: AM1.12 (X3), C8.1, HE8.2 (OUT)
HE9: AM2.1 (X4), C9.1, HE9.2 (OUT)
HE10: AM2.2 (X6), C10.1, HE10.2 (OUT)
HE11: AM2.4 (X7), C11.1, HE11.2 (OUT)
HE12: AM2.5 (X5), C12.1, HE12.2 (OUT)
HE13: AM2.15 (X2), C13.1, HE13.2 (OUT)
HE14: AM2.14 (X1), C14.1, HE14.2 (OUT)
HE15: AM2.13 (X0), C15.1, HE15.2 (OUT)
HE16: AM2.12 (X3), C16.1, HE16.2 (OUT)
HE17: AM3.1 (X4), C17.1, HE17.2 (OUT)
HE18: AM3.2 (X6), C18.1, HE18.2 (OUT)
HE19: AM3.4 (X7), C19.1, HE19.2 (OUT)
HE20: AM3.5 (X5), C20.1, HE20.2 (OUT)
HE21: AM3.15 (X2), C21.1, HE21.2 (OUT)
HE22: AM3.14 (X1), C22.1, HE22.2 (OUT)
HE23: AM3.13 (X0), C23.1, HE23.2 (OUT)
HE24: AM3.12 (X3), C24.1, HE24.2 (OUT)
HE25: AM4.1 (X4), C25.1, HE25.2 (OUT)
HE26: AM4.2 (X6), C26.1, HE26.2 (OUT)
HE27: AM4.4 (X7), C27.1, HE27.2 (OUT)
HE28: AM4.5 (X5), C28.1, HE28.2 (OUT)
HE29: AM4.15 (X2), C29.1, HE29.2 (OUT)
HE30: AM4.14 (X1), C30.1, HE30.2 (OUT)
HE31: AM4.13 (X0), C31.1, HE31.2 (OUT)
HE32: AM4.12 (X3), C32.1, HE32.2 (OUT)
HE33: AM5.1 (X4), C33.1, HE33.2 (OUT)
HE34: AM5.2 (X6), C34.1, HE34.2 (OUT)
HE35: AM5.4 (X7), C35.1, HE35.2 (OUT)
HE36: AM5.5 (X5), C36.1, HE36.2 (OUT)
HE37: AM5.15 (X2), C37.1, HE37.2 (OUT)
HE38: AM5.14 (X1), C38.1, HE38.2 (OUT)
HE39: AM5.13 (X0), C39.1, HE39.2 (OUT)
HE40: AM5.12 (X3), C40.1, HE40.2 (OUT)
HE41: AM6.1 (X4), C41.1, HE41.2 (OUT)
HE42: AM6.2 (X6), C42.1, HE42.2 (OUT)
HE43: AM6.4 (X7), C43.1, HE43.2 (OUT)
HE44: AM6.5 (X5), C44.1, HE44.2 (OUT)
HE45: AM6.15 (X2), C45.1, HE45.2 (OUT)
HE46: AM6.14 (X1), C46.1, HE46.2 (OUT)
HE47: AM6.13 (X0), C47.1, HE47.2 (OUT)
HE48: AM6.12 (X3), C48.1, HE48.2 (OUT)
HE49: AM7.1 (X4), C49.1, HE49.2 (OUT)
HE50: AM7.2 (X6), C50.1, HE50.2 (OUT)
HE51: AM7.4 (X7), C51.1, HE51.2 (OUT)
HE52: AM7.5 (X5), C52.1, HE52.2 (OUT)
HE53: AM7.15 (X2), C53.1, HE53.2 (OUT)
HE54: AM7.14 (X1), C54.1, HE54.2 (OUT)
HE55: AM7.13 (X0), C55.1, HE55.2 (OUT)
HE56: AM7.12 (X3), C56.1, HE56.2 (OUT)
HE57: AM8.1 (X4), C57.1, HE57.2 (OUT)
HE58: AM8.2 (X6), C58.1, HE58.2 (OUT)
HE59: AM8.4 (X7), C59.1, HE59.2 (OUT)
HE60: AM8.5 (X5), C60.1, HE60.2 (OUT)
HE61: AM8.15 (X2), C61.1, HE61.2 (OUT)
HE62: AM8.14 (X1), C62.1, HE62.2 (OUT)
HE63: AM8.13 (X0), C63.1, HE63.2 (OUT)
HE64: AM8.12 (X3), C64.1, HE64.2 (OUT)
HE65: AM9.1 (X4), C65.1, HE65.2 (OUT)
HE66: AM9.2 (X6), C66.1, HE66.2 (OUT)
HE67: AM9.4 (X7), C67.1, HE67.2 (OUT)
HE68: AM9.5 (X5), C68.1, HE68.2 (OUT)
MUX_OUT_1: AM1.3 (X), U1.17 (PA3)
MUX_OUT_2: AM2.3 (X), U1.20 (PA4)
MUX_OUT_3: AM3.3 (X), U1.21 (PA5)
MUX_OUT_4: AM4.3 (X), U1.22 (PA6)
MUX_OUT_5: AM5.3 (X), U1.23 (PA7)
MUX_OUT_6: AM6.3 (X), U1.24 (PC4)
MUX_OUT_7: AM7.3 (X), U1.25 (PC5)
MUX_OUT_8: AM8.3 (X), U1.26 (PB0)
MUX_OUT_9: AM9.3 (X), U1.27 (PB1)
MUX_SELECT_0: AM1.11 (A), AM2.11 (A), AM3.11 (A), AM4.11 (A), AM5.11 (A), AM6.11 (A), AM7.11 (A), AM8.11 (A), AM9.11 (A), U1.9 (PC1)
MUX_SELECT_1: AM1.10 (B), AM2.10 (B), AM3.10 (B), AM4.10 (B), AM5.10 (B), AM6.10 (B), AM7.10 (B), AM8.10 (B), AM9.10 (B), U1.10 (PC2)
MUX_SELECT_2: AM1.9 (C), AM2.9 (C), AM3.9 (C), AM4.9 (C), AM5.9 (C), AM6.9 (C), AM7.9 (C), AM8.9 (C), AM9.9 (C), U1.11 (PC3)
USB_D+: U1.35 (OTGHS1_D+), U5.4 (I/O2)
USB_D-: U1.34 (OTGHS1_D-), U5.3 (I/O2)
USB_PLUG_D+: J1.5, U5.6 (I/O1)
USB_PLUG_D-: J1.6, U5.1 (I/O1)
VBUS: F1.1, J1.1, J1.2
