Phylliida/piano/(commit log)

2026-11-10 Import the tile design as it stood on 2026-10-20
    The 8 x 5 tile: shared geometry (tilegeom.py), the circuit as data
    (tile_circuit.py), the generators, the printed case, and the partly
    routed board in pcb/. The older 68-key and single-board designs come
    along unchanged for now.
    Left out by .gitignore: the reference clones in refs/, raw web scrapes
    and the browser profile in research/, scratch in work/, KiCad's backups
    and local state, and vendor datasheets.
    [coupon_cover.stl, coupon_pcb_dummy.stl, coupon_tray.stl, cover.stl, hex35.kicad_pcb, hex70.kicad_pcb, magnetic_switch_prices.csv, panel96.kicad_pcb]
2026-11-13 Route the tile board
    route_board.py adds, in place, everything the hand routing left open on
    pcb/tile.kicad_pcb, using the small router in pcbroute.py: the 40 sensor
    outputs into their muxes, the mux selects and outputs, +3.3VA, VIN between
    the four ports, the four UARTs, what U1 needs, a ground via at every ground
    pad and vias that tie the two ground pours together. KiCad's DRC with
    schematic parity reports 0 errors and 0 unrouted connections.
    The circuit changed where the copper asked for it (tile_circuit.py, and
    the schematic regenerated from it):
    - each mux reads its row's keys in the channel order their tracks arrive in
    (CHANNEL_OF_COL)
    - U1: selects on PB0/PC5/PC4, mux outputs on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
    [tile.kicad_pcb, tile.kicad_sch]
2026-11-13 pcb/README: the board is routed
    How it is routed, stage by stage; the pin map the firmware needs (selects,
    ADC channels, select value per column, UARTs, debug pads); the bootloader
    ports after the UART moves (W and S); how to route again.
2026-11-13 Case: tiles snap together, cables go in from underneath
    Tile to tile: dovetail rails on the E and N walls run in through slots in
    the next tile's W and S walls, and one snap latch per seam holds a tile
    down. A tile is lowered onto its W and S neighbours, so an assembly is
    built outward from its south-west tile.
    Cables: at every port the cover is notched and both walls are open from the
    PCB's back to the floor, so the 50 mm cable is laid in from underneath with
    the covers on.
    Cover: the catches are now cantilever beams with a bump and a pry notch.
    gen_case.py checks all of it on the solids before it writes anything (two
    neighbouring trays clear each other, a tile can be lowered onto the ra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
    [coupon_cover.stl, coupon_pcb_dummy.stl, coupon_tray.stl, cover.stl, tray.stl]
2026-11-13 Hub: the circuit as data; tile and hub share one circuit helper
    hub_circuit.py holds every part and connection of the hub: AT32F405 on
    the computer's USB, a CH224A asking a charger for 15 V on a second
    USB-C socket, two TPS259470A eFuses switching either supply onto VIN,
    the tile port, two LEDs and two buttons. Nothing draws or places it
    yet: the symbols, schematic, board and case are still to come.
    circuit.py is the parts-and-connections helper that used to live in
    tile_circuit.py. The tile's parts and nets are unchanged (compared
    before and after as data).
2026-11-13 Hub: symbols, eFuse footprint and schematic; schematics read better
    gen_hub_lib.py makes the hub's library: the AT32F405 symbol (the tile's),
    symbols for the TPS259470A eFuse and the CH224A drawn from their
    datasheets, and the eFuse's RPW0010A footprint from TI's land pattern.
    gen_hub_sch.py draws hub_circuit.py; KiCad's netlist of the result equals
    the circuit (74 parts, 57 nets) and ERC is clean.
    gen_sch.py now draws either circuit. Pins stacked on one spot (the USB-C
    symbol's four GND pins) are drawn once. Reference and value texts go
    where the symbol library puts them instead of on top of the wires, and a
    power symbol between an IC's connected pins goes out beyond their labels.
    The ti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
    [hub.kicad_sch, tile.kicad_sch]
2026-11-14 Firmware: tile and hub programs, tested on a PC, never run on hardware
    core/ holds everything that does not touch the chip: the frame format,
    the link on one port, the beacon tree, key scanning and calibration,
    the hub's tile table, notes and MIDI, the power policy and the PD chip's
    registers. sim/ runs whole keyboards on a PC with the real tile and hub
    programs. make test: 9 programs, 119 tests, 0 failed.
    port/at32f405, tile/ and hub/ build with arm-none-eabi-gcc but have not
    run on a board. STATUS.md lists what is missing (the tile flashing
    script, above all) and README.md what is untested.
    [at32f402_405_conf.h, board.h, ch224.c, ch224.h, console.c, flash.c, flash.h, frame.c]
